jcgeau/Analog-Macropad/Fiches Techniques/S6de507808860464e940a03270d6d7923Y-154386098.png

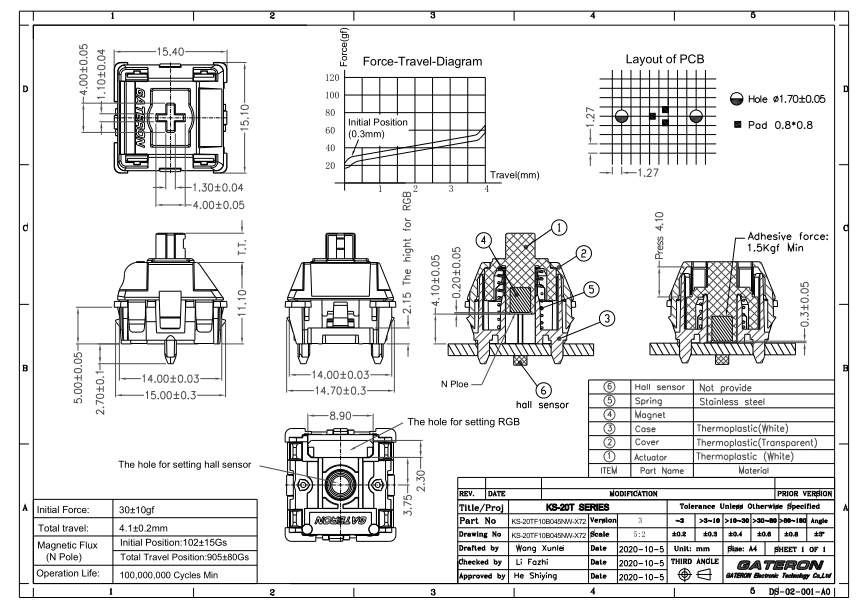
Fiches Techniques/S6de507808860464e940a03270d6d7923Y-154386098.png
