jcgeau/Analog-Macropad/Case/macropad plate.stl

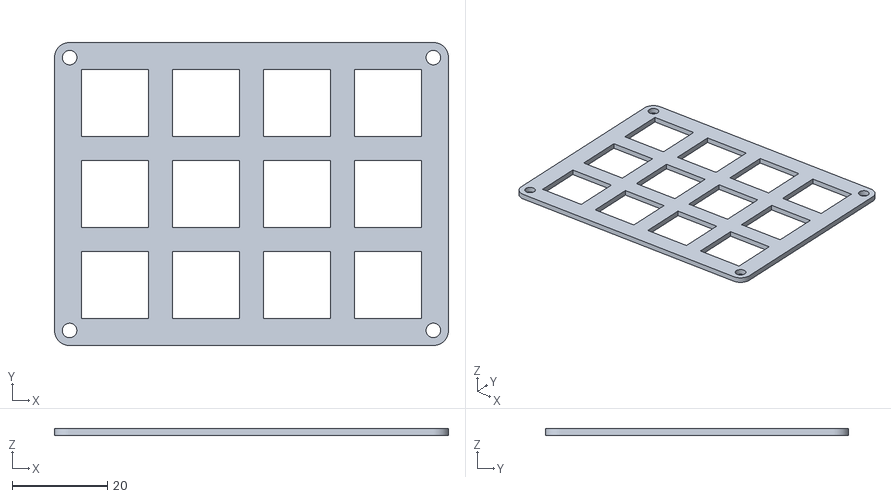
[picture p2: CAD file, 2024-08-06]
Case/macropad plate.stl
82.6 x 63.5 x 1.50
