jcgeau/Analog-Macropad/PCB/analog-macropad/analog-macropad.kicad_pcb

## KiCad design PCB/analog-macropad/analog-macropad.kicad_pcb (2024-07-24)

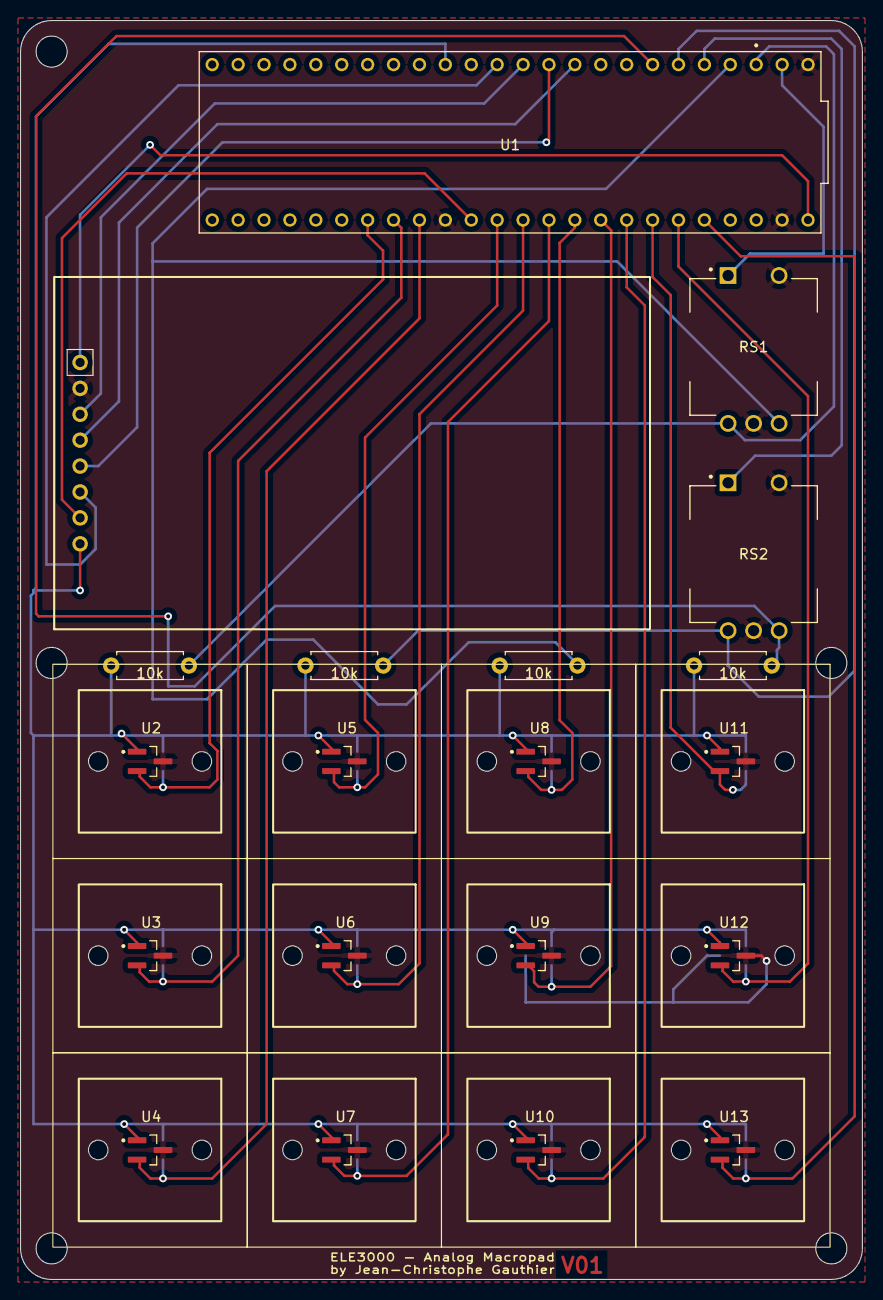
[picture p3: board analog-macropad.kicad_pcb from above]

Board: 2 copper layers, 82.6 x 123.4 mm, 20 parts (0 on the bottom side), 26 nets.

Parts:
10k, 10k#2, 10k#3, 10k#4: 10k; R_Axial_DIN0207_L6.3mm_D2.5mm_P7.62mm_Horizontal
RS1, RS2: rotary encoder
U1: Teensy 4.1
U2, U3, U4, U5, U6, U7, U8, U9, U10, U11, U12, U13: hall-effect sensor; hall sensor
U14: ST7735

Connections:
3.3V: 10k.2, 10k#2.2, 10k#3.2, 10k#4.2, U1.3.3V_1 (3.3V), U2.1 (VCC), U3.1 (VCC), U4.1 (VCC), U5.1 (VCC), U6.1 (VCC), U7.1 (VCC), U8.1 (VCC), U9.1 (VCC), U10.1 (VCC), U11.1 (VCC), U12.1 (VCC), U13.1 (VCC), U14.8 (LED)
5V: U1.VIN, U14.1 (VCC)
A0: U1.14 (A0), U5.2 (VOUT)
A1: U1.15 (A1), U6.2 (VOUT)
A2: U1.16 (A2), U7.2 (VOUT)
A3: U1.17 (A3), U8.2 (VOUT)
A4: U1.18 (A4), U9.2 (VOUT)
A5: U1.19 (A5), U10.2 (VOUT)
A6: U1.20 (A6), U11.2 (VOUT)
A7: U1.21 (A7), U12.2 (VOUT)
A8: U1.22 (A8), U13.2 (VOUT)
A15: U1.39 (A15), U2.2 (VOUT)
A16: U1.40 (A16), U3.2 (VOUT)
A17: U1.41 (A17), U4.2 (VOUT)
CLK1: 10k#2.1, RS1.1 (A), U1.1 (TX1)
CLK2: 10k#3.1, RS2.1 (A), U1.4 (BCLK2)
CS: U1.10 (CS1), U14.3 (CS_U1)
DC: U1.9 (OUT1C), U14.5 (AO)
DT1: 10k.1, RS1.3 (B), U1.2 (OUT2)
DT2: 10k#4.1, RS2.3 (B), U1.5 (IN2)
GND: RS1.2 (C), RS1.5 (S2), RS2.2 (C), RS2.5 (S2), U1.GND1 (GND), U1.GND2 (GND), U1.GND3 (GND), U2.3 (GND), U3.3 (GND), U4.3 (GND), U5.3 (GND), U6.3 (GND), U7.3 (GND), U8.3 (GND), U9.3 (GND), U10.3 (GND), U11.3 (GND), U12.3 (GND), U13.3 (GND), U14.2 (GND)
RST: U1.8 (TX2), U14.4 (RESET)
SCK: U1.13 (SCK), U14.7 (SCK)
SDA: U1.11 (MOSI), U14.6 (SDA)
SW1: RS1.4 (S1), U1.0 (RX1)
SW2: RS2.4 (S1), U1.3 (LRCLK2)
