jcgeau/Analog-Macropad/Code/Clavier/main/AnalogKey.h

#ifndef ANALOG_KEY_H
#define ANALOG_KEY_H



#include <_Teensy.h>
#include <Arduino.h>

#include "Constants.h"

enum Joystick {

    NO,
    X_RIGHT,
    X_LEFT,
    Y_UPPER,
    Y_LOWER

};

class AnalogKey {

    public:

    AnalogKey();
    AnalogKey(int port);
    ~AnalogKey();

    const int GetValue();
    const int GetMacro();

    void SetPort(int pin);
    void SetValue(int value);
    void SetJoystick(enum Joystick direction);


    unsigned int BuffAvg();

    void KeyRead(); 
    void MoveJoystick();    
    void KeyPress();
    void KeyRelease();
    void SetMacro(const int (&macro)[MAX_MACRO_SIZE]);
    bool IsPressed(unsigned int treshold);

    void Test();

    private:
    
    int _macro[MAX_MACRO_SIZE]{0}; 
    unsigned int _analogValue;
    int _buffer[BUFFER_SIZE] = {0};
    int _buffer_i{0};
    int _pin;
    int _max{310};
    int _min{150};
    enum Joystick _direction{NO};
    bool _pressed{0};
    unsigned int _deadzone{20};

};


#endif
