jcgeau/Analog-Macropad/(commit log)

2024-05-16 déclaration des classes AnalogKey et AnalogKeyboard
2024-05-16 ajustement des fichiers
2024-05-16 continuation du code implémentation de quelques méthodes
2024-05-24 reformulation du code pour utiliser une autre library que Keyboard
2024-05-27 creation des fcts read write et print de keayboard
2024-06-18 version fonctionnel de une touche
2024-07-10 création du projet pcb et l'implémentation des macros fonctionnent
    [analog-macropad.kicad_pcb, analog-macropad.kicad_sch]
2024-07-11 finit le circuit design presque pret a commencer le pcb
    [analog-macropad.kicad_sch]
2024-07-17 pcb finit pret a commander
    [analog-macropad.kicad_pcb, analog-macropad.kicad_sch]
2024-07-24 pcb commandé avec quelques changements au code
    [analog-macropad-B_Cu.gbl, analog-macropad-B_Mask.gbs, analog-macropad-B_Paste.gbp, analog-macropad-B_Silkscreen.gbo, analog-macropad-Edge_Cuts.gm1, analog-macropad-F_Cu.gtl, analog-macropad-F_Mask.gts, analog-macropad-F_Paste.gtp]
2024-07-28 implémentation de la classe encoder
2024-07-29 création de la classe screen pour gérer l'interface usager
2024-07-31 Implémentation des fonctions tests pour faciliter le test de chaque composantes
2024-08-04 quasi fin de la fonction run et implémentation de l'affichage en mode veille
2024-08-06 debug de la classe rotary encoder
    [macropad plate.stl]
